GOCKHAM/Ultihorloge/README.md

# Ultihorloge

This GitHub page will be continuously updated over time with code and other relevant documents.

## **Pin Schematic**
Here U can find a pin schematic picture of my project.
