GOCKHAM/Ultihorloge/Documentatie/Handleiding/Note Red Import File/README.txt

Open Note Red and import the "NoteRed Import Flow" on the windows tab.

Have fun!! :)
