GOCKHAM/Ultihorloge/Documentatie/Technisch/Multicriteria Analyse Hardware.xlsx

1) Rood ledje:
Kenmerk | 3mm LED Diffuus Rood (10-pack) | Wegingsfactor (1-5) | Score (1-5) | Totaal | 3mm Transparant Rood 500mcd | Score (1-5) | Totaal
Grootte | 3mm | 1 | 5 | 5 | 3mm | 5 | 5
Spanning | 2V | 4 | 5 | 20 | 2V | 5 | 20
Stroomverbruik | 20mA | 5 | 5 | 25 | 20mA | 5 | 25
Lichtopbrengst | 500mcd | 2 | 5 | 10 | 500mcd | 5 | 10
Prijs | €1.50 | 3 | 3 | 9 | €0.20 | 5 | 15
Eindtotaal |  |  |  | 69 |  |  | 75
2) Ventilatoren:
Kenmerk | Wegingsfactor (1-6) | Mini Fan 25x25x7mm 5V | Score (1-5) | Totaal | Sunon Ventilator 25x25x10mm | Score (1-5) | Totaal | Sunon Ventilator 40x40x10mm | Score (1-5) | Totaal
Grootte | 6 | 25x25x7mm | 4 | 24 |  | 3 | 18 | 40x40x10mm | 2 | 12
 |  |  |  |  | 25x25x10mm
Spanning | 2 | 5V | 5 | 10 | 5V | 5 | 10 | 5V | 5 | 10
Stroomverbruik | 5 | 0.1 A | 3 | 15 | 0.075 A | 4 | 20 | 0,12A | 2 | 10
Luchtstroom | 3 | 5 m³/h | 4 | 12 | 5 m³/h | 4 | 12 | 11,8 m³/h | 2 | 6
Geluidsniveau | 1 | 25.68 dBA | 3 | 3 | 16 dBA | 4 | 4 | 27 dBA | 2 | 2
Prijs | 4 | €4.95 | 4 | 16 | €5.50 | 3 | 12 | €6.50 | 2 | 8
Eindtotaal |  |  |  | 80 |  |  | 76 |  |  | 48
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
