GOCKHAM/Ultihorloge/Documentatie/Handleiding/GebruikersHandleiding.docx

# Gebruikershandleiding

# Inleiding

Gefeliciteerd met uw nieuwe UltiHorloge! Dit innovatieve horloge is speciaal ontworpen om u te helpen koeler te blijven tijdens het sporten, vooral op warme dagen. Het biedt ook inzicht in uw lichaamsparameters en locatiegegevens. Deze handleiding helpt u om snel aan de slag te gaan met alle functies van uw UltiHorloge.

# Aan de slag

## Het horloge inschakelen

1. Schuif de kleine schakelaar aan de zijkant van het horloge naar de "AAN"-positie.
2. Na enkele seconden zal het scherm oplichten en de tijd en datum weergeven.

## Het horloge dragen

1. Plaats het horloge om uw pols met het scherm aan de bovenkant.
2. Zorg ervoor dat de onderkant van het horloge (waar de koeling zit) goed contact maakt met uw huid.
3. Maak de band comfortabel vast, maar niet te strak.

# Functies en bediening

## Knoppen

Uw UltiHorloge heeft drie knoppen aan de zijkant.

### Knop 1 (Bovenste knop)

- Kort indrukken: Meet en toont temperatuur en vochtigheid
- Het scherm zal eerst de temperatuur en vochtigheid tonen, daarna automatisch overschakelen naar uw GPS-locatie

### Knop 2 (Middelste knop)

- Kort indrukken: Meet en toont de buitentemperatuur via je GPS coordinaten dat bepaald wordt via de gps-sensor

### Knop 3 (Onderste knop)

- Kort indrukken: Keert terug naar het hoofdscherm met tijd en datum

## Schermweergave

Het OLED-scherm van uw UltiHorloge toont verschillende informatie, afhankelijk van welke functie actief is.

### Hoofdscherm (tijd en datum)

- Toont de huidige tijd in groot formaat
- Toont de dag en datum in klein formaat
- Toont WiFi-verbindingsstatus

### Temperatuur- en vochtigheidscherm

- Toont de huidige omgevingstemperatuur in graden Celsius
- Toont de huidige luchtvochtigheid in percentage

### GPS-locatiescherm

- Toont uw huidige breedtegraad (latitude)
- Toont uw huidige lengtegraad (longitude)

### Buiten Temperatuur

- Toont de huidige buitenTemperatuur van de stad via je gps-sensor

## Automatische koeling

Het UltiHorloge is uitgerust met een innovatieve koelfunctie via Peltier Module

### Automatische activering

- De koeling wordt automatisch geactiveerd wanneer de omgevingstemperatuur boven 30°C komt
- U zult een lichte koeling voelen aan de onderkant van het horloge

### Handmatige activering

- U kunt de koelfunctie ook handmatig activeren via de app of webpagina (zie volgende sectie)

### Koelduur

- Om de batterij te sparen, werkt de koeling in cycli
- Na 10 seconden koeling volgt een pauze van 15 minuten

## Webinterface voor weersinformatie

Uw UltiHorloge kan ook weersinformatie weergeven via een webpagina.

### Verbinding maken

- Verbind uw smartphone of computer met hetzelfde WiFi-netwerk als uw UltiHorloge
- Open uw webbrowser en voer het IP-adres van uw horloge in (dit vindt u in de productdocumentatie)

### Weersinformatie bekijken

- Voer de stad in en de webpagina toont het huidige weer op uw locatie
- U kunt ook de weersverwachting voor de komende dagen zien
- U kunt handmatig een andere locatie invoeren om het weer daar te bekijken

## Telegram-waarschuwingen

Uw UltiHorloge kan u waarschuwen via Telegram-berichten wanneer de temperatuur te hoog wordt

### Instellen

- Volg de Telegram-bot genoemd in de productdocumentatie
- Stuur het bericht "/start" naar de bot om de waarschuwingen te activeren

### Waarschuwingen

- U ontvangt automatisch een bericht wanneer de omgevingstemperatuur boven 30°C stijgt
- Het bericht bevat de exacte temperatuur en het tijdstip van meting
- U ontvangt geen nieuwe waarschuwingen totdat de temperatuur eerst onder 28°C is gedaald

## Batterij en opladen

### Batterijduur

- Het UltiHorloge heeft een batterijduur van ongeveer enkele uren bij normaal gebruik
- Als de koelfunctie vaak wordt gebruikt, kan de batterijduur korter zijn

### Opladen

- Gebruik de meegeleverde USB-kabel om het horloge op te laden
- Sluit de kabel aan op de poort aan de onderkant van het horloge
- Een volledige oplaadsessie duurt ongeveer 2 uur
- Tijdens het opladen brandt er een rood lampje, dat blauw wordt wanneer de batterij volledig is opgeladen

## Probleemoplossing

Het scherm blijft leeg

- Controleer of de schakelaar in de "AAN"-positie staat
- Controleer of de batterij is opgeladen
- Houd Knop 3 10 seconden ingedrukt om het horloge te resetten

De koelfunctie werkt niet

- Zorg ervoor dat de onderkant van het horloge goed contact maakt met uw huid
- Controleer of de batterij voldoende is opgeladen
- De koelfunctie werkt alleen boven 30°C of bij handmatige activering

Geen GPS-signaal

- Ga naar buiten met vrij zicht op de lucht
- Het kan enkele minuten duren voordat het GPS-signaal wordt verkregen
- Controleer of het horloge is verbonden met WiFi

Kan geen verbinding maken met de webpagina

- Controleer of uw smartphone of computer op hetzelfde WiFi-netwerk is aangesloten
- Probeer het IP-adres opnieuw in te voeren
- Reset het horloge door de schakelaar uit en weer aan te zetten
