GOCKHAM/Ultihorloge/Documentatie/Technisch/Project Schema PIN.pdf

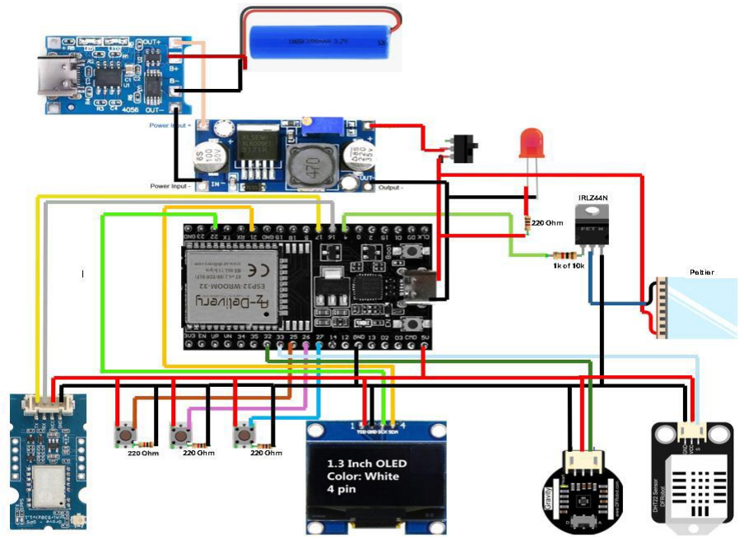
[picture p1: figure]
