GOCKHAM/Ultihorloge/Documentatie/Handleiding/3D Print STL File/full project.3mf

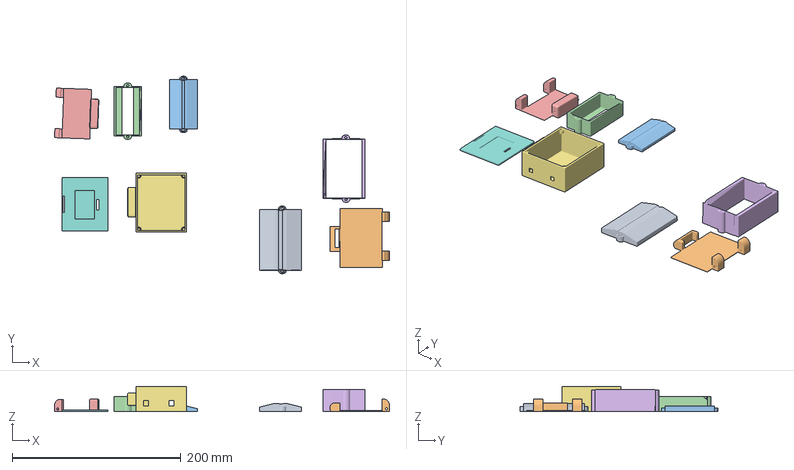
[picture p2: CAD file, 2025-06-05]
Documentatie/Handleiding/3D Print STL File/full project.3mf
397.1 x 234.3 x 30.0 mm
Merged x 4
Bottom1.stl
Bottom2.stl
Top.stl
CoverTop.stl
