GOCKHAM/Ultihorloge/Documentatie/Handleiding/3D Print STL File/Mid 2.stl

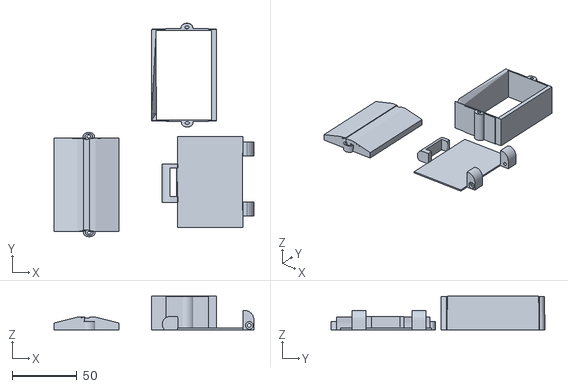
[picture p3: CAD file, 2025-06-05]
Documentatie/Handleiding/3D Print STL File/Mid 2.stl
154.2 x 164.7 x 26.0
