GOCKHAM/Ultihorloge/Documentatie/Handleiding/Test Document.xlsx

USER STORY 1: Unit Test
Scenario | Voorwaarden | Knop ingedrukt? | Gemeten temperatuur (°C) | Gemeten vochtigheid (%) | Verwacht resultaat | Getest resultaat | Reden | Test Ok?
1a | Sensor laten werken voor het eerste keer | Nee | / | / | Sensor moet waarde geven | Geen meting | Sensor niet correct aangesloten | Nee (Automatische meting)
2a | Sensor start in warme omgeving | Nee | 15.8 | 55 | Sensor moet correcte waarde geven | wel meting, maar niet juist | Sensor correct aangesloten, maar fout in code | Nee (Automatische meting)
2b | Sensor start in warme omgeving opnieuw | Nee | 45.2 | 100 | Sensor moet waarde geven boven 25 graden | Onrealistische waarde (45°C) ?? | Opnieuw fout in code | Nee (Automatische meting)
2c | Sensor start in warme omgeving opnieuw | Nee | 26.7 | 48 | Sensor moet waarde geven boven 25 graden | Stabiele waarden | Sensor correct afgeschermd, juiste code | JA (Automatische meting)
3a | sensor laten werken met drukknop | Ja | / | / | sensor moet waarde geven d.m.v knop 1 | Geen meting | knop verkeerd aangesloten | Nee (Manuele meting)
3b | sensor laten werken met drukknop opnieuw | Ja | / | / | sensor moet waarde geven d.m.v knop 1 | Geen meting | Knop defect | Nee (Manuele meting)
3c | sensor laten werken met drukknop opnieuw | Ja | 25.5 | 51 | sensor moet waarde geven d.m.v knop 1 | wel meting | Nieuwe knop aangesloten | JA Manuele meting)
USER STORY 2: Unit test
Scenario | Voorwaarden | Knop ingedrukt? | Verwacht resultaat | Getest resultaat | Reden | Test Ok?
1a | Hartslag testen bij rusten | Nee | Er moet een waarde komen staan | geen uitlezing | VScode te uitgebreid en fout | Nee (Automatische meting)
1b | Hartslag testen bij rusten opnieuw | Nee | BPM moet stabiel zijn | Wel uitlezing, maar onstabiel | VSCode nog steeds fout | Nee (Automatische meting)
1c | Hartslag testen bij rusten opnieuw | Nee | BPM moet stabiel zijn | Wel uitlezing en stabiel bij rust | VSCode bij BPM in rust correct verbeterd | JA (Automatische meting)
2a | Hartslag testen na 5 minuten beweging | Nee | BPM moet stijgen | BPM is gestegen | VSCode bij BPM in beweging correct | JA (Automatische meting)
3a | hartslag testen met drukknop | Ja | Correcte waarde geven bij knopmmeting | geen uitlezing | Knop defect | Nee (Manuele meting)
3b | hartslag testen met drukknop opnieuw | Ja | Correcte waarde geven bij knopmmeting | wel uitlezing | Knop en kabels vervangen | JA Manuele meting)
4a | Hartslag testen na 5 minuten beweging met drukknop | Ja | BPM moet weer stijgen en werken met drukknop | BPM gestegen bij knopmeting | Knop en code juist geimplementeerd | JA Manuele meting)
USER STORY 3: Real World Test
Scenario | Voorwaarden | Knop ingedrukt? | Verwacht resultaat | Getest resultaat | Reden | Test Ok?
1a | GPS getest binnen | Nee | Geen signaal krijgen | Blijft op 0.0 | GPS werkt niet binnen | Nee (Automatische meting)
2a | GPS getest buiten | Nee | Locatie correct binnen krijgen | Geeft waarde 0.0 | Klein foutje in code | Nee (Automatische meting)
2b | GPS getest buiten stilstaand | Nee | Locatie correct binnen krijgen | Geeft betere waarde | Code verbeterd | JA (Automatische meting)
2c | GPS getest buiten positie verplaatst | Nee | Locatie correct binnen krijgen | GPS signaal stabiel | Goede ontvangst | JA (Automatische meting)
3a | GPS getest buiten met drukknop | Ja | Knop moet werken en de gps sensor moet coordinaten doorgeven | Blijft op 0.0 | knop verkeerd aangesloten | Nee (Manuele meting)
3b | GPS getest buiten met drukknop | Ja | Knop moet werken en de gps sensor moet coordinaten doorgeven | GPS signaal stabiel | Goede ontvangst | JA Manuele meting)
USER STORY 4: Integratietest
Scenario | Voorwaarden | Knop ingedrukt? | Verwacht resultaat | Getest resultaat | Reden | Test Ok?
1a | Display is aangesloten en toont alle resultaten | Nee | Alle gegevens tonen | Geen display | Sensor verkeerd aangesloten | Nee
1b | Display is aangesloten en toont alle resultaten | Nee | Alle gegevens tonen | Geen display | Foute sensor type gekozen en fout in de main code | Nee
1c | Display is aangesloten en toont alle resultaten | Nee | Alle gegevens tonen | Wel display maar niet duidelijk | In VSCode grote layout gekozen | Ja/Nee
1d | Display is aangesloten en toont alle resultaten | Nee | Alle gegevens tonen | Duidelijke, leesbare layout | VSCode is juist geimplementeerd voor automatische meting | JA (Automatische meting)
2a | Display is aangesloten en toont alle resultaten met een knop | Ja | Alle gegevens tonen d.m.v knop | Knop werkt niet | Knop defect | Nee
2b | Display is aangesloten en toont alle resultaten met een knop | Ja | Alle gegevens tonen d.m.v knop | Knop werkt wel, maar niet stabiel | VSCode, knop debounce aanpassen | Nee
2c | Display is aangesloten en toont alle resultaten met een knop | ja | Alle gegevens tonen d.m.v knop | Oude waarde blijft staan | Display ververst niet correct | Nee
2d | Display is aangesloten en toont alle resultaten met een knop | Ja | Alle gegevens tonen d.m.v knop | Knop werkt en code is juist en stabiel | Code juist geimplementeerd | JA Manuele meting)
USER STORY 5: Stresstest
Scenario | Voorwaarden | Knop ingedrukt? | Verwacht resultaat | Getest resultaat | Reden | Test Ok?
1a | Peltier gaat automatisch aan voor 5 seconden | Nee | koeling geven | wel koeling, maar is continu aan | Code logica Note Red verkeerd | Nee
1b | Peltier gaat automatisch aan voor 5 seconden | Nee | koeling geven en dan uitschakelen | wel koeling, maar is continu aan | Mosfet is niet zo efficient | Nee
1c | Peltier gaat automatisch aan voor 5 seconden | Nee | koeling geven en dan uitschakelen | wel koeling, maar is continu aan + ESP32 wordt gereset | Peltier voeding en GND op de esp32 aangesloten | Nee
1d | Peltier gaat automatisch aan voor 5 seconden | Nee | koeling geven en dan uitschakelen | Koeling genereert en wordt uitgeschakeld | Peltier voeding en GND op de batterij aangesloten | JA (Automatische meting)
2a | Peltier gaat aan d.m.v drukknop voor 5 seconden | Ja | koeling geven en dan uitschakelen | Geen koeling | Code logica Note Red verkeerd | Nee
2b | Peltier gaat aan d.m.v drukknop voor 5 seconden | Ja | koeling geven en dan uitschakelen | wel koeling, maar is continu aan | Code logica Note Red verkeerd | Nee
2c | Peltier gaat aan d.m.v drukknop voor 5 seconden | Ja | koeling geven en dan uitschakelen | wel koeling, maar is continu aan | Code logica Note Red verkeerd | Nee
2d | Peltier gaat aan d.m.v drukknop voor 5 seconden | Ja | koeling geven en dan uitschakelen | Koeling genereert en wordt uitgeschakeld | Code logica is juist | JA Manuele meting)
USER STORY 6: Integratie Test
Scenario | Voorwaarden | Verwacht resultaat | Getest resultaat | Reden | Test Ok?
1a | Sensor stuurt temperatuurwaarde van 24°C via MQTT naar Node-RED | Node-RED ontvangt correcte waarde via sensor/temperature topic | Waarde niet ontvangen | Topicnaam was verkeerd gespeld (sensor/temp), aangepast in ESP32-code | Nee
1b | Temperatuurwaarde > 25°C wordt doorgestuurd | Node-RED activeert Telegram-waarschuwing | Telegram melding niet gestuurrd | Telegram flow was niet gekoppeld aan het juiste function-blok in Node-RED | Nee
1c | Temperatuurwaarde > 25°C wordt doorgestuurd | Telegram ontvangt waarschuwing met exacte temperatuur en tijd | Telegram melding niet gestuurrd | JSON-structuur fout – ontbrekende haak in payload – opgelost in ESP32-code | Nee
2a | Drukknop op ESP32 activeert meting | Node-RED ontvangt MQTT-bericht van button1/control en voert loggingflow uit | Geen bericht ontvangen op NoteRed | ESP32 verstuurde verkeerde topic, aangepast naar button1/control | Nee
3a | Node-RED stuurt data naar Notion API | Data verschijnt correct in Notion database (velden: temperatuur, tijd, status) | Data niet verschenen | Authorization-header was fout – API-key verkeerd ingevoegd – opgelost in Node-RED | Nee
4a | Elke 15 minuten stuurt ESP32 automatisch data | Node-RED ontvangt data, verwerkt deze, stuurt door naar Notion | Note Red heeft data correct ontvangen | Na fixen van alle topics en API-problemen werkt de logica volledig zoals verwacht | ja
5a | Foutieve payload (temperatuur als string) wordt verzonden | Node-RED toont foutmelding en logt fout in debug node | Foutmelting wordt getoond op notered | Validatie toegevoegd aan flow – fout wordt nu correct afgehandeld zonder crash | ja
USER STORY 7: Integratietest
Scenario | Voorwaarden | Knop ingedrukt? | Verwacht resultaat | Getest resultaat | Reden | Test Ok?
1a | Telegram automatisch melding sturen bij temp. > 25 °C | Nee | waarschuwing notificatie sturen | Geen notificatie ontvangen | Telegram chatID verkeerd | Nee
1b | Telegram automatisch melding sturen bij temp. > 25 °C | Nee | waarschuwing notificatie sturen | wel notificatie ontvangen, maar bij elke temp. | Note red logica niet juist | Nee
1c | Telegram automatisch melding sturen bij temp. > 25 °C | Nee | waarschuwing notificatie sturen | wel notificatie ontvangen | Note Red implementatie juist gemaakt | JA (Automatische meting)
2a | Telegram manueel melding sturen bij temp. > 25 °C | ja | waarschuwing notificatie sturen | Telegram geen melding ontvangen | Note Red knop logica niet juist | Nee
2b | Telegram manueel melding sturen bij temp. > 25 °C | ja | waarschuwing notificatie sturen | Telegram geen melding ontvangen | Note Red knop logica niet juist | Nee
2c | Telegram manueel melding sturen bij temp. > 25 °C | ja | waarschuwing notificatie sturen | Telegram wel melding ontvangen | Note Red logica verbeterd | JA Manuele meting)
USER STORY 8: Real World test
Scenario | Voorwaarden | Uitgesproken opdracht | Verwacht resultaat | Getest resultaat | Reden | Test Ok?
1a | Peltier laten werken door spraakopdracht | Peltier inschakelen | Koeling moet starten bij spraak voor 5 seconden | Siri werkt niet | Siri stond niet aan | Nee
1b | Peltier laten werken door spraakopdracht | Activeer Koeling | Koeling moet starten bij spraak voor 5 seconden | Siri integratie op GSM fout gedaan | Verkeerde POST request verstuurd | Nee
1c | Peltier laten werken door spraakopdracht | Activeer Koeling | Koeling moet starten bij spraak voor 5 seconden | Geen Koeling | Note Red spraak flow verkeerd | Nee
1d | Peltier laten werken door spraakopdracht | Activeer Koeling | Koeling moet starten bij spraak voor 5 seconden | Wel Koeling maar wordt niet uitgeschakeld | Note Red spraak flow verkeerd | Nee
1e | Peltier laten werken door spraakopdracht | Activeer Koeling | Koeling moet starten bij spraak voor 5 seconden | Wel Koeling voor 5 seconden | Note Red logica juist | JA
USER STORY 9: Load Test
Scenario | Voorwaarden | Knop ingedrukt? | Testduur / Aantal metingen | Netwerkstatus | Verzonden data | Verwacht resultaat | Getest resultaat | Reden | Test Ok?
1a | Notion data opvangen d.m.v Note Red | Nee | 1 uur, 4 metingen | Verbonden | Volledige data | Alle datas moeten om de 15min automatisch naar notion komen | Geen data ontvangen | Note Red logica verkeerd | Nee
1b | Notion data opvangen d.m.v Note Red | Nee | 1 uur, 4 metingen | Verbonden | Volledige data | Alle datas moeten om de 15min automatisch naar notion komen | Geen data ontvangen | Verkeerde Notion API gebruikt | Nee
1c | Notion data opvangen d.m.v Note Red | Nee | 2 uur, 8 metingen | Verbonden | Volledige data | Alle datas moeten om de 15min automatisch naar notion komen | Gedeeltelijk ontvangen | Kolom titel niet dezelfde als op de Note Red (Hoofdletter gevoelig) | Nee
1d | Notion data opvangen d.m.v Note Red | Nee | 1 uur, 4 metingen | Niet verbonden | Volledige data | Alle datas moeten om de 15min automatisch naar notion komen | Geen data ontvangen | Wifi connectie van ESP32 verbroken = geen connectie tot Note Red | Nee
1d | Notion data opvangen d.m.v Note Red | Nee | 1 uur, 4 metingen | Verbonden | Volledige data | Alle datas moeten om de 15min automatisch naar notion komen | Wel ontvangen | Note Red logica verbeterd | JA (Automatische meting)
2a | Notion data opvangen d.m.v Note Red via drukknop | Ja | 10 manuele in 5 minuten | Verbonden | Volledige data | Alle datas op Notion hebben ontvangen via drukknop meting | Geen data ontvangen | Knop logica op de Note Red verkeerd | Nee
2b | Notion data opvangen d.m.v Note Red via drukknop | Ja | 20 metingen in 5 minuten gestuurd | Verbonden | Volledige data | Alle datas op Notion hebben ontvangen via drukknop meting | Geen data ontvangen | Knop logica op de Note Red steeds verkeerd | Nee
2c | Notion data opvangen d.m.v Note Red via drukknop | Ja | 5 metingen in 10 minuten | Verbonden | Volledige data | Alle datas op Notion hebben ontvangen via drukknop meting | Wel ontvangen | Logica juist geimplementeerd | JA Manuele meting)
USER STORY 10: Integratietest
Scenario | Ingevoerde Stad | Netwerkverbinding | Verwachte weergave | Gerealiseerde weergave | Probleem | Oplossing / Actie
1a | Antwerpen | Verbonden | Vandaag + 3 dagen, helder | Geen reactie | API-sleutel niet toegevoegd in code | OpenWeather API-key correct toegevoegd
1b | Antwerpen | Verbonden | Vandaag + 3 dagen, helder | “City not found” | API-query structuur fout | Endpoint URL herbouwd met juiste parameters
1c | Brussel | Verbonden | Regen, temperatuur zichtbaar | Alleen temperatuur zichtbaar | Sleutels in JSON niet correct uitgelezen | JSON-parsing in Node-RED aangepast
1d | Gent | Verbonden | Alles correct (temp, icon, beschrijving) | Alles correct | / | /
1e | Luik | Geen internet | Geen weergegevens | Foutmelding “API niet bereikbaar” | Geen netwerkverbinding | Verbinding gecontroleerd, fallbackbericht toegevoegd
2a | Stad met tikfout: “Antwrpen” | Verbonden | Foutmelding verwacht | Default waarde weer | Geen foutafhandeling bij onbekende stad | Try/catch toegevoegd in de backend code
2b | Stad ingevoerd met cijfers “1234” | Verbonden | Foutmelding verwacht | App crasht | Input validatie ontbrak | Regex-check voor stadnamen toegevoegd
