GOCKHAM/Ultihorloge/Implementatie/src/credentialss.h

// Add your WiFi Credentials here
#define ssid ""
#define password ""


// MQTT-instellingen
#define mqtt_server "" // Raspberry Pi IP-adres
#define mqtt_port = 8883
#define mqtt_username ""  // Add your MQTT username here
#define mqtt_password ""  // Add your MQTT password here
